Mansi-1120/soft-balloon-actuator-state-estimation/data collection/raw/pessure sensing noisy data.png

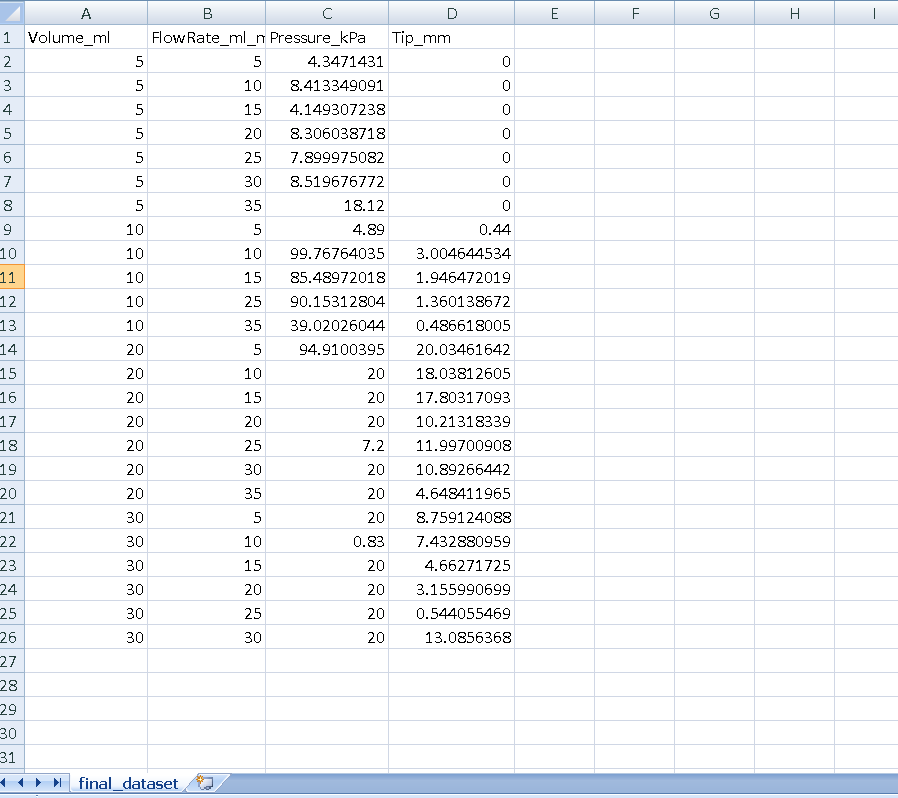
data collection/raw/pessure sensing noisy data.png
