Mansi-1120/soft-balloon-actuator-state-estimation/stl files for 3d printing/marker2.STL

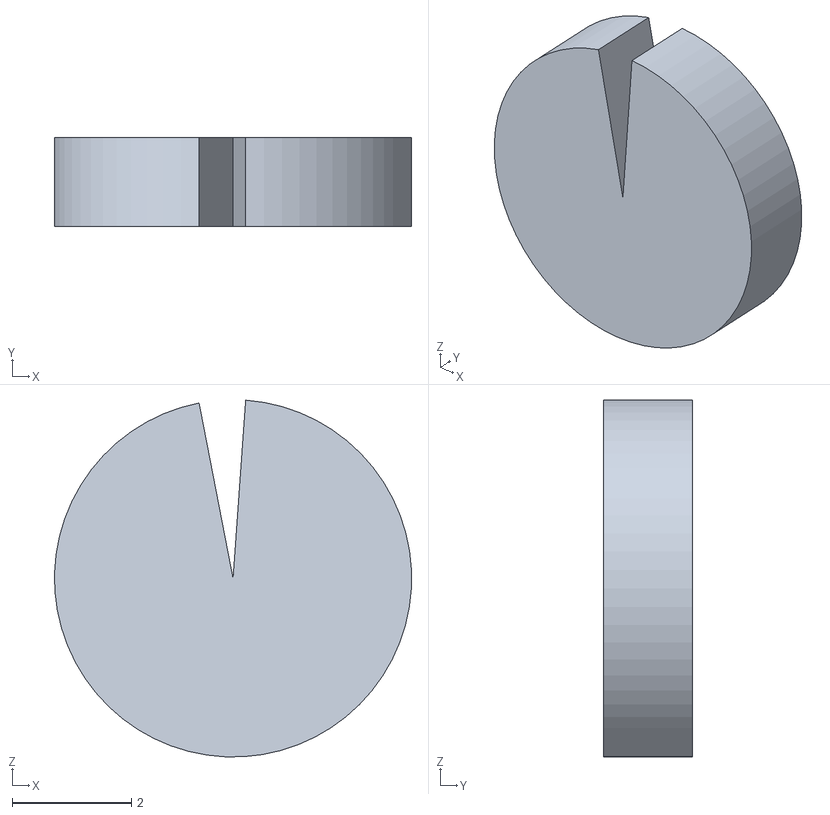
[picture p10: CAD file, 2026-04-30]
stl files for 3d printing/marker2.STL
6.00 x 1.50 x 5.99
