Mansi-1120/soft-balloon-actuator-state-estimation/cad for laser cutting & 3d printing/Stand.SLDPRT

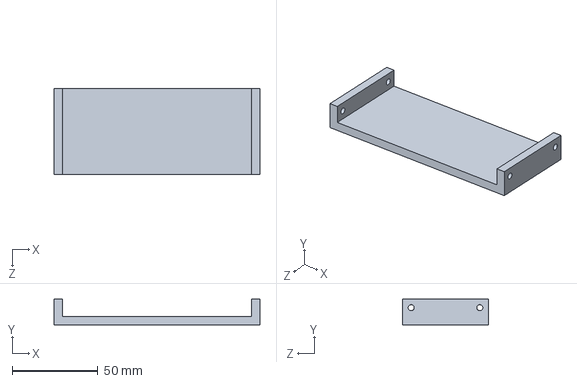
[picture p11: CAD file, 2026-04-30]
cad for laser cutting & 3d printing/Stand.SLDPRT
120.0 x 15.0 x 50.0 mm
