Mansi-1120/soft-balloon-actuator-state-estimation/stl files for 3d printing/Board Keeper.STL

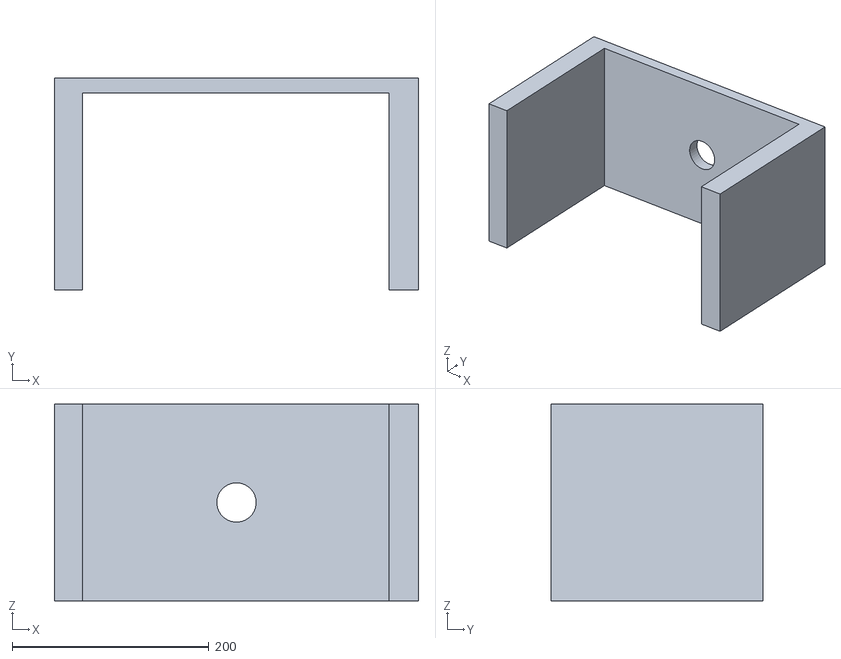
[picture p12: CAD file, 2026-04-30]
stl files for 3d printing/Board Keeper.STL
370.0 x 215.0 x 200.0
