Mansi-1120/soft-balloon-actuator-state-estimation/cad for laser cutting & 3d printing/Bottom plate for AL.SLDPRT

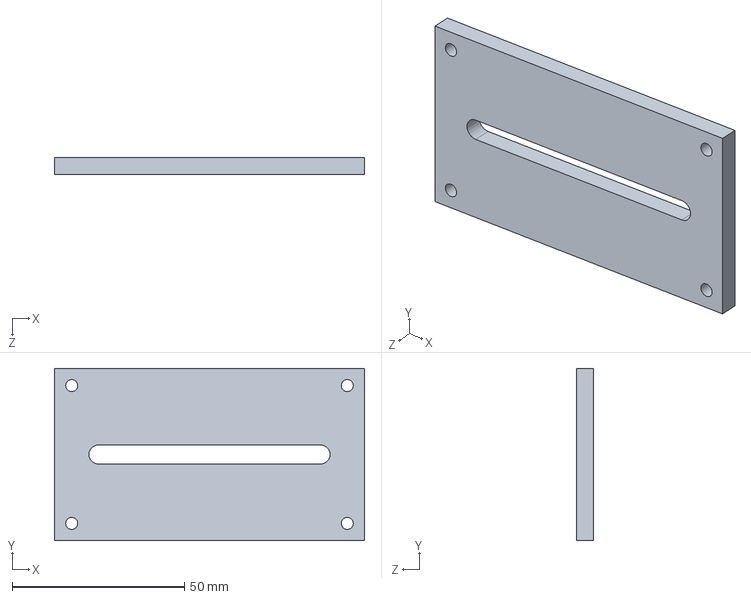
[picture p13: CAD file, 2026-04-30]
cad for laser cutting & 3d printing/Bottom plate for AL.SLDPRT
90.0 x 50.0 x 5.00 mm
