Mansi-1120/soft-balloon-actuator-state-estimation/stl files for 3d printing/camera_mount_camra.3MF

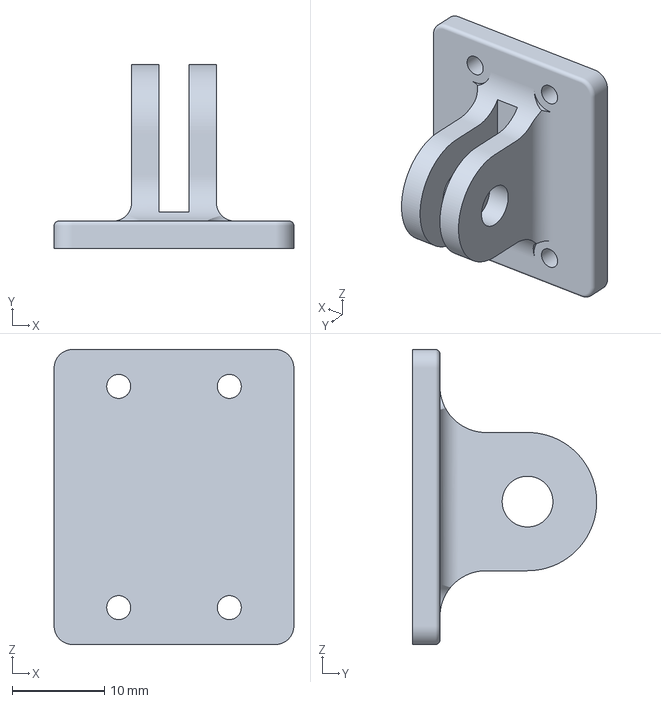
[picture p14: CAD file, 2026-04-30]
stl files for 3d printing/camera_mount_camra.3MF
26.0 x 20.0 x 32.0 mm
