Mansi-1120/soft-balloon-actuator-state-estimation/cad for laser cutting & 3d printing/GoPro Flat Mount Tripod Side.SLDPRT

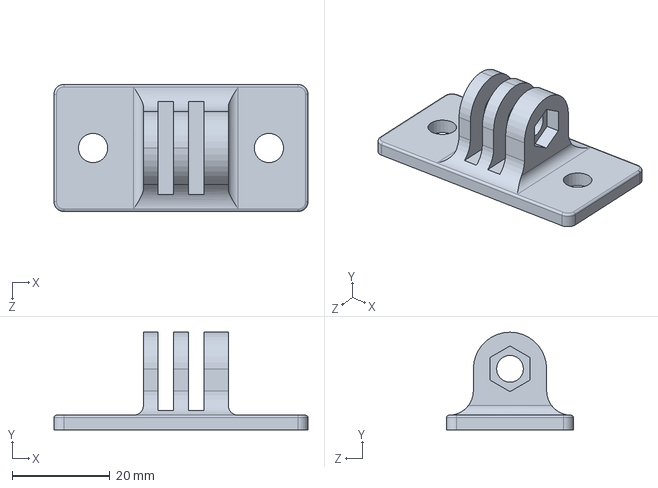
[picture p15: CAD file, 2026-04-30]
cad for laser cutting & 3d printing/GoPro Flat Mount Tripod Side.SLDPRT
52.0 x 20.0 x 26.0 mm
