Mansi-1120/soft-balloon-actuator-state-estimation/cad for laser cutting & 3d printing/Table.SLDPRT

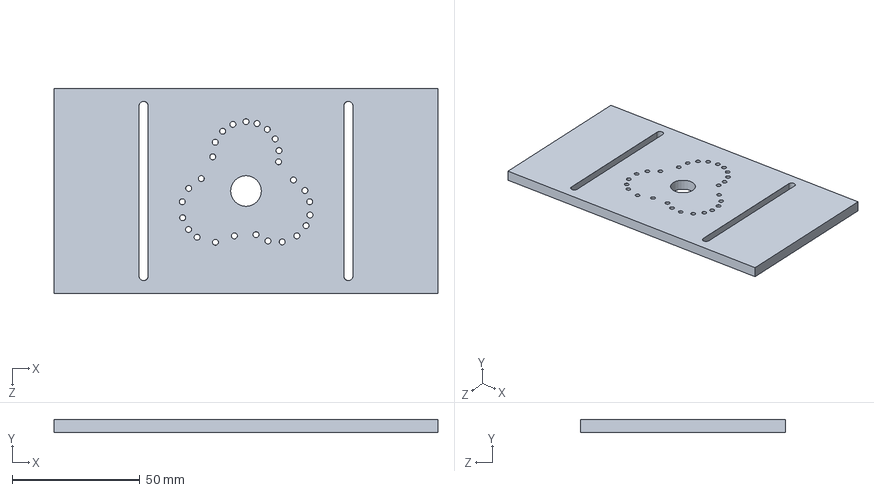
[picture p16: CAD file, 2026-04-30]
cad for laser cutting & 3d printing/Table.SLDPRT
150.0 x 5.00 x 80.0 mm
