Mansi-1120/soft-balloon-actuator-state-estimation/cad for laser cutting & 3d printing/GoPro Flat Mount Camera Side.SLDPRT

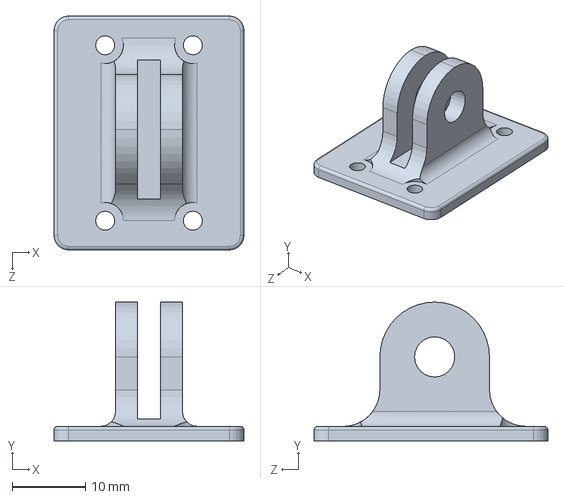
[picture p17: CAD file, 2026-04-30]
cad for laser cutting & 3d printing/GoPro Flat Mount Camera Side.SLDPRT
26.0 x 19.0 x 32.0 mm
