Mansi-1120/soft-balloon-actuator-state-estimation/cad for laser cutting & 3d printing/GoPro Camera Side Screw Adapter.SLDPRT

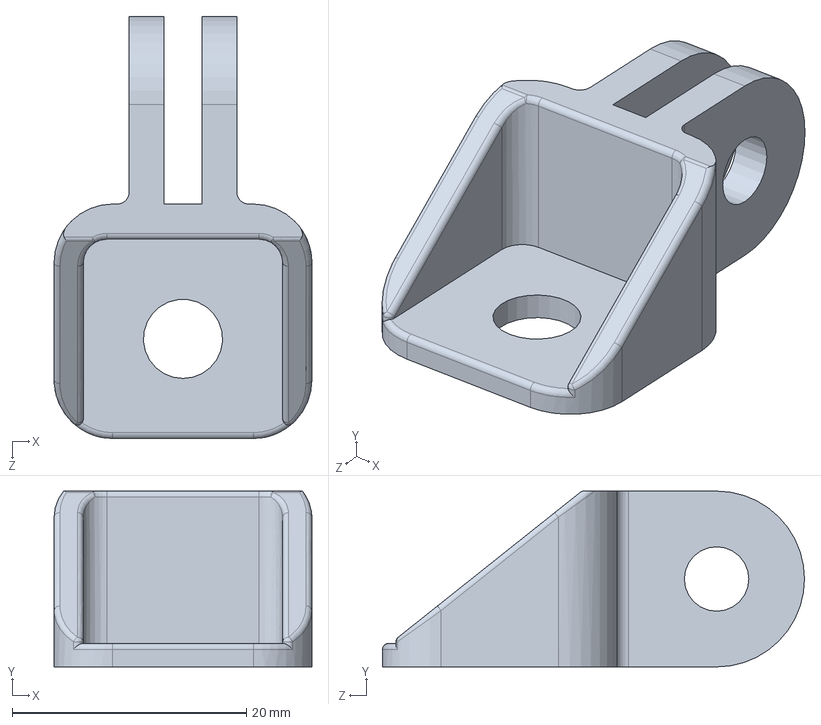
[picture p18: CAD file, 2026-04-30]
cad for laser cutting & 3d printing/GoPro Camera Side Screw Adapter.SLDPRT
22.0 x 15.0 x 36.0 mm
