Mansi-1120/soft-balloon-actuator-state-estimation/(list of files, cad)

Other CAD files:
cad for laser cutting & 3d printing/camera_mount_camra.SLDPRT
stl files for 3d printing/GoPro Flat Mount Tripod Side.3MF
cad for laser cutting & 3d printing/keeeper.SLDPRT
stl files for 3d printing/Stand.STL
stl files for 3d printing/GoPro Camera Side Screw Adapter.STL
cad for laser cutting & 3d printing/Bottom plate for AL.DXF
cad for laser cutting & 3d printing/Bottom plate for AL.SLDDRW
cad for laser cutting & 3d printing/Table.DXF
cad for laser cutting & 3d printing/Table.SLDDRW
