Mansi-1120/soft-balloon-actuator-state-estimation/(commit log)

2026-04-30 adding all the files to the initial commit
    [10 ml-min.csv, 15 ml-min.csv, 20 ml-min.csv, 25 ml-min.csv, 30 ml-min.csv, 35 ml-min.csv, 5 ml-min.csv, Board Keeper.STL]
2026-09-25 README: replace pressure screenshot with marker tracking video section
